slu4coder/Minimal-UART-CPU-FLASH-Edition/README.md

# Minimal UART CPU (Revision 1.3 aka FLASH Edition)

This repo is deprecated. The information you are looking for has moved to: https://github.com/slu4coder/Minimal-UART-CPU-System
