slu4coder/Minimal-UART-CPU-FLASH-Edition/(list of files, drawings)

Other design files:
KiCAD/8-Bit CPU 32k.dsn
