slu4coder/Minimal-UART-CPU-FLASH-Edition/KiCAD/8-Bit CPU 32k.kicad_pcb

## KiCad design KiCAD/8-Bit CPU 32k.kicad_pcb (2021-04-17, last stored version)

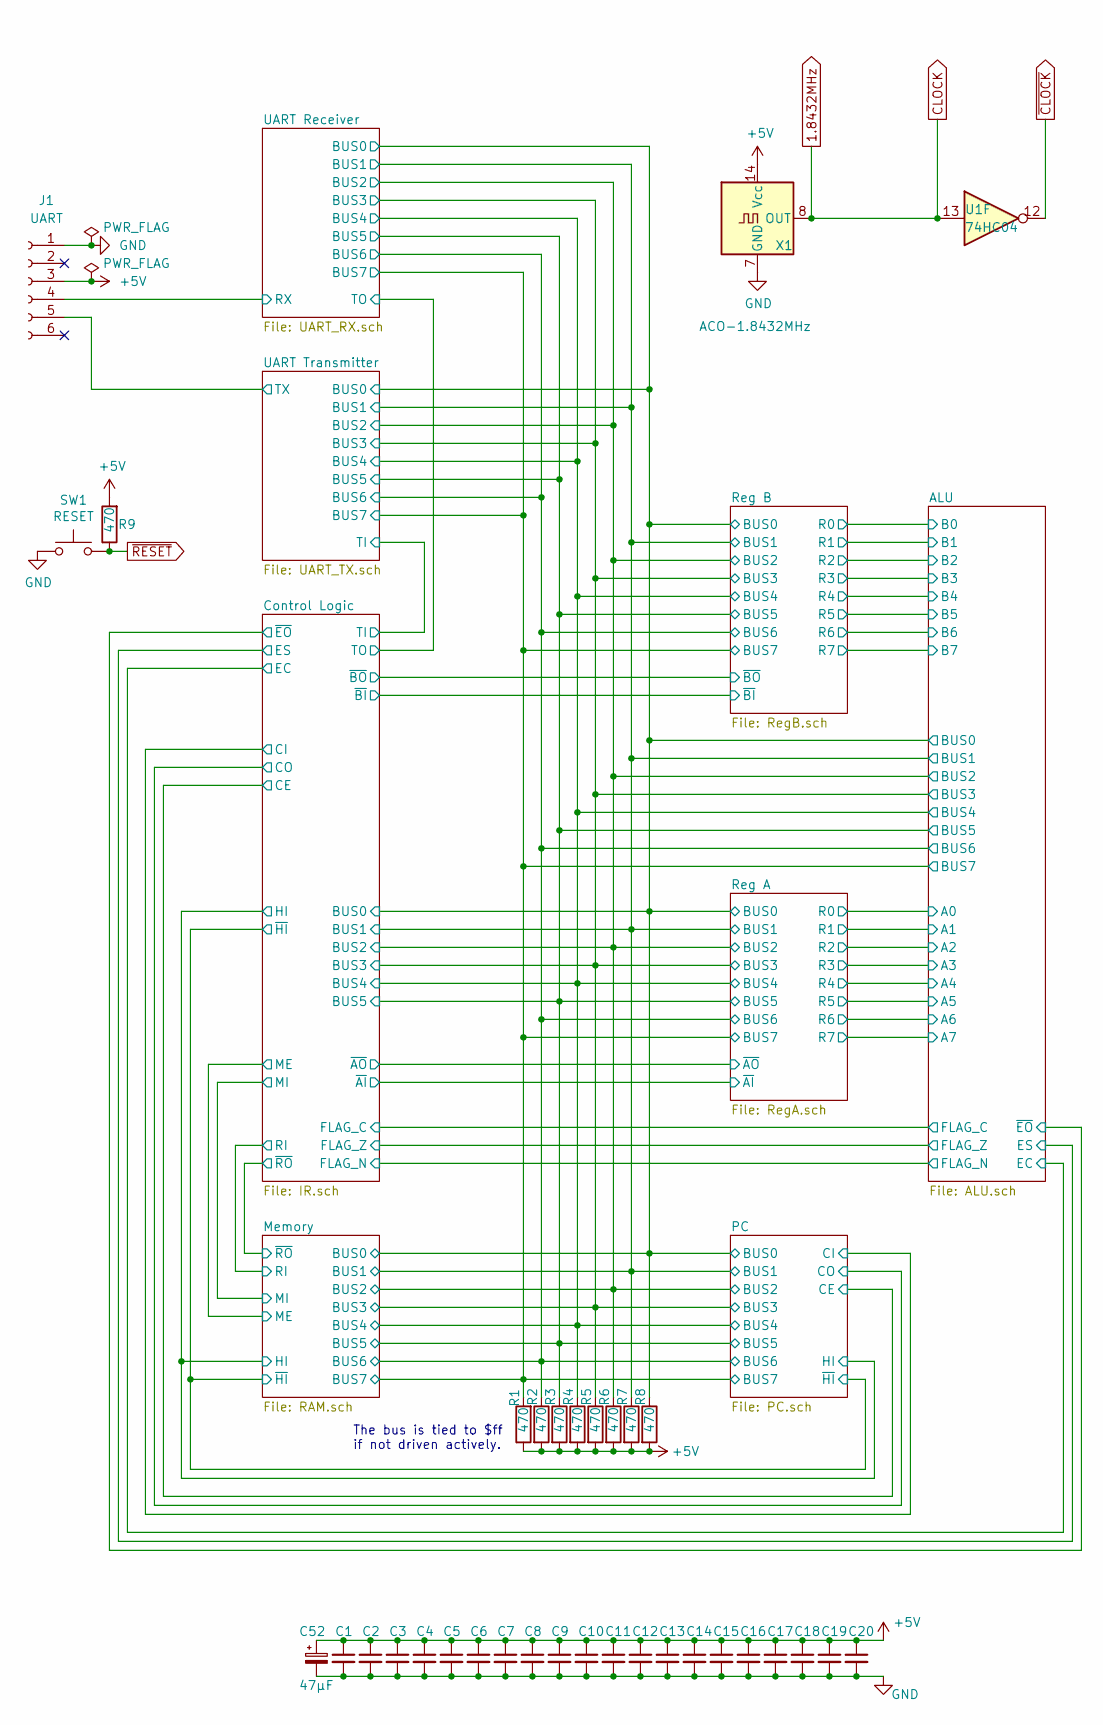
[picture p1: schematic 8-Bit CPU 32k.sch, Minimal UART Computer (FLASH Edition)]

Parts:
C1, C2, C3, C4, C5, C6, C7, C8, C9, C10, C11, C12, C13, C14, C15, C16, C17, C18, C19, C20: 100nF; C_Disc_D5.0mm_W2.5mm_P2.50mm
C52: 47µF; CP_Radial_D7.5mm_P2.50mm
J1: UART; PinSocket_1x06_P2.54mm_Vertical
R1, R2, R3, R4, R5, R6, R7, R8, R9: 470; R_Axial_DIN0207_L6.3mm_D2.5mm_P7.62mm_Horizontal
SW1: RESET; SW_PUSH_6mm
U1: 74HC04; DIP-14_W7.62mm
X1: ACO-1.8432MHz; Oscillator_DIP-14

Connections:
1.8432MHz: U1.13, X1.8 (OUT); also elsewhere on the board
+5V: C1.1, C2.1, C3.1, C4.1, C5.1, C6.1, C7.1, C8.1, C9.1, C10.1, C11.1, C12.1, C13.1, C14.1, C15.1, C16.1, C17.1, C18.1, C19.1, C20.1, C52.1, J1.3, R1.1, R2.2, R3.2, R4.2, R5.2, R6.2, R7.2, R8.2, R9.2, X1.14 (Vcc); also elsewhere on the board
/ALU/BUS0: R8.1; also elsewhere on the board
/ALU/BUS1: R7.1; also elsewhere on the board
/ALU/BUS2: R6.1; also elsewhere on the board
/ALU/BUS3: R5.1; also elsewhere on the board
/ALU/BUS4: R4.1; also elsewhere on the board
/ALU/BUS5: R3.1; also elsewhere on the board
/ALU/BUS6: R2.1; also elsewhere on the board
/ALU/BUS7: R1.2; also elsewhere on the board
/UART Receiver/RX: J1.4; also elsewhere on the board
/UART Transmitter/TX: J1.5; also elsewhere on the board
GND: C1.2, C2.2, C3.2, C4.2, C5.2, C6.2, C7.2, C8.2, C9.2, C10.2, C11.2, C12.2, C13.2, C14.2, C15.2, C16.2, C17.2, C18.2, C19.2, C20.2, C52.2, J1.1, SW1.1, X1.7 (GND); also elsewhere on the board
~CLOCK: U1.12; also elsewhere on the board
~RESET: R9.1, SW1.2; also elsewhere on the board

Notes on the sheet:
The bus is tied to $ff if not driven actively.

Schematic: RegA.sch, A Register

Parts:
U2, U3: 74HC173; DIP-16_W7.62mm
U4: 74HC245; DIP-20_W7.62mm

Connections:
1.8432MHz: U2.7, U3.7; also elsewhere on the board
+5V: U2.16, U3.16, U4.1 (A->B), U4.20 (VCC); also elsewhere on the board
/ALU/A0: U3.3, U4.2 (A0); also elsewhere on the board
/ALU/A1: U3.4, U4.3 (A1); also elsewhere on the board
/ALU/A2: U3.5, U4.4 (A2); also elsewhere on the board
/ALU/A3: U3.6, U4.5 (A3); also elsewhere on the board
/ALU/A4: U2.3, U4.6 (A4); also elsewhere on the board
/ALU/A5: U2.4, U4.7 (A5); also elsewhere on the board
/ALU/A6: U2.5, U4.8 (A6); also elsewhere on the board
/ALU/A7: U2.6, U4.9 (A7); also elsewhere on the board
/ALU/BUS0: U3.14, U4.18 (B0); also elsewhere on the board
/ALU/BUS1: U3.13, U4.17 (B1); also elsewhere on the board
/ALU/BUS2: U3.12, U4.16 (B2); also elsewhere on the board
/ALU/BUS3: U3.11, U4.15 (B3); also elsewhere on the board
/ALU/BUS4: U2.14, U4.14 (B4); also elsewhere on the board
/ALU/BUS5: U2.13, U4.13 (B5); also elsewhere on the board
/ALU/BUS6: U2.12, U4.12 (B6); also elsewhere on the board
/ALU/BUS7: U2.11, U4.11 (B7); also elsewhere on the board
/Control Logic/~AI: U2.9, U2.10, U3.9, U3.10; also elsewhere on the board
/Control Logic/~AO: U4.19 (CE); also elsewhere on the board
GND: U2.1, U2.2, U2.8, U2.15, U3.1, U3.2, U3.8, U3.15, U4.10 (GND); also elsewhere on the board

Schematic: ALU.sch, Arithmetic and Logic Unit

Parts:
U12, U16: 74HC86; DIP-14_W7.62mm
U13, U14: 74HC283; DIP-16_W7.62mm
U15: 74HC245; DIP-20_W7.62mm
U18: 74HC02; DIP-14_W7.62mm
U19: 74HC08; DIP-14_W7.62mm

Connections:
+5V: U12.14 (VCC), U13.16, U14.16, U15.20 (VCC), U16.14 (VCC), U18.14 (VCC), U19.14 (VCC); also elsewhere on the board
/ALU/A0: U14.5; also elsewhere on the board
/ALU/A1: U14.3; also elsewhere on the board
/ALU/A2: U14.14; also elsewhere on the board
/ALU/A3: U14.12; also elsewhere on the board
/ALU/A4: U13.5; also elsewhere on the board
/ALU/A5: U13.3; also elsewhere on the board
/ALU/A6: U13.14; also elsewhere on the board
/ALU/A7: U13.12; also elsewhere on the board
/ALU/B0: U16.13; also elsewhere on the board
/ALU/B1: U16.10; also elsewhere on the board
/ALU/B2: U16.5; also elsewhere on the board
/ALU/B3: U16.2; also elsewhere on the board
/ALU/B4: U12.13; also elsewhere on the board
/ALU/B5: U12.10; also elsewhere on the board
/ALU/B6: U12.5; also elsewhere on the board
/ALU/B7: U12.2; also elsewhere on the board
/ALU/BUS0: U15.2 (A0); also elsewhere on the board
/ALU/BUS1: U15.3 (A1); also elsewhere on the board
/ALU/BUS2: U15.4 (A2); also elsewhere on the board
/ALU/BUS3: U15.5 (A3); also elsewhere on the board
/ALU/BUS4: U15.6 (A4); also elsewhere on the board
/ALU/BUS5: U15.7 (A5); also elsewhere on the board
/ALU/BUS6: U15.8 (A6); also elsewhere on the board
/ALU/BUS7: U15.9 (A7); also elsewhere on the board
/ALU/EC: U14.7; also elsewhere on the board
/ALU/ES: U12.1, U12.4, U12.9, U12.12, U16.1, U16.4, U16.9, U16.12; also elsewhere on the board
/ALU/FLAG_C: U13.9; also elsewhere on the board
/ALU/FLAG_N: U13.10, U15.11 (B7), U18.12; also elsewhere on the board
/ALU/FLAG_Z: U19.6; also elsewhere on the board
/ALU/~EO: U15.19 (CE); also elsewhere on the board
GND: U12.7 (GND), U13.8, U14.8, U15.1 (A->B), U15.10 (GND), U16.7 (GND), U18.7 (GND), U19.7 (GND); also elsewhere on the board
unnamed: U12.3, U13.11
unnamed: U12.6, U13.15
unnamed: U12.8, U13.2
unnamed: U12.11, U13.6
unnamed: U13.1, U15.13 (B5), U18.9
unnamed: U13.4, U15.14 (B4), U18.8
unnamed: U13.7, U14.9
unnamed: U13.13, U15.12 (B6), U18.11
unnamed: U14.1, U15.17 (B1), U18.3
unnamed: U14.2, U16.8
unnamed: U14.4, U15.18 (B0), U18.2
unnamed: U14.6, U16.11
unnamed: U14.10, U15.15 (B3), U18.6
unnamed: U14.11, U16.3
unnamed: U14.13, U15.16 (B2), U18.5
unnamed: U14.15, U16.6
unnamed: U18.1, U19.1
unnamed: U18.4, U19.2
unnamed: U18.10, U19.12
unnamed: U18.13, U19.13
unnamed: U19.3, U19.4
unnamed: U19.5, U19.11

Notes on the sheet:
Left-over AND used in UART receier.

Schematic: UART_RX.sch, UART Receiver

Parts:
U1: 74HC04; DIP-14_W7.62mm
U19: 74HC08; DIP-14_W7.62mm
U20: 74HC173; DIP-16_W7.62mm
U34: 74HC161; DIP-16_W7.62mm
U35: 74HC00; DIP-14_W7.62mm
U37: 74HC193; DIP-16_W7.62mm
U39: 74HC164; DIP-14_W7.62mm
U41: 74HC245; DIP-20_W7.62mm

Connections:
1.8432MHz: U34.2, U35.13; also elsewhere on the board
+5V: U20.16, U34.7, U34.9, U34.10, U34.16, U35.14 (VCC), U37.5, U37.9, U37.15, U37.16, U39.2 (DSB), U39.9 (~MR), U39.14 (VCC), U41.1 (A->B), U41.20 (VCC); also elsewhere on the board
/ALU/BUS0: U41.11 (B7); also elsewhere on the board
/ALU/BUS1: U41.12 (B6); also elsewhere on the board
/ALU/BUS2: U41.13 (B5); also elsewhere on the board
/ALU/BUS3: U41.14 (B4); also elsewhere on the board
/ALU/BUS4: U41.15 (B3); also elsewhere on the board
/ALU/BUS5: U41.16 (B2); also elsewhere on the board
/ALU/BUS6: U41.17 (B1); also elsewhere on the board
/ALU/BUS7: U41.18 (B0); also elsewhere on the board
/ALU/FLAG_Z: U19.6; also elsewhere on the board
/Control Logic/TO: U35.10; also elsewhere on the board
/UART Receiver/RX: U35.1, U39.1 (DSA); also elsewhere on the board
GND: U20.1, U20.2, U20.8, U20.9, U20.10, U20.11, U20.12, U20.13, U20.15, U34.8, U35.7 (GND), U37.1, U37.8, U37.10, U37.14, U39.7 (GND), U41.10 (GND); also elsewhere on the board
unnamed: U1.5, U19.10, U37.13
unnamed: U1.6, U20.14
unnamed: U1.10, U35.12
unnamed: U1.11, U35.8, U41.19 (CE)
unnamed 103: U19.1; also elsewhere on the board
unnamed 104: U19.2; also elsewhere on the board
unnamed 105: U19.12; also elsewhere on the board
unnamed 106: U19.13; also elsewhere on the board
unnamed: U19.3, U19.4
unnamed: U19.8, U34.1
unnamed: U19.9, U35.3, U35.4, U37.11
unnamed: U19.5, U19.11
unnamed: U20.3, U35.9
unnamed: U34.11, U37.4, U39.8 (CP)
unnamed: U35.2, U35.6
unnamed: U35.5, U35.11
unnamed: U39.3 (Q0), U41.2 (A0)
unnamed: U39.4 (Q1), U41.3 (A1)
unnamed: U39.5 (Q2), U41.4 (A2)
unnamed: U39.6 (Q3), U41.5 (A3)
unnamed: U39.10 (Q4), U41.6 (A4)
unnamed: U39.11 (Q5), U41.7 (A5)
unnamed: U39.12 (Q6), U41.8 (A6)
unnamed: U39.13 (Q7), U41.9 (A7)
~CLOCK: U20.7; also elsewhere on the board

Notes on the sheet:
~RESET
~SET
AND from ALU
SYNC_DATA_READY

Schematic: UART_TX.sch, UART Transmitter

Parts:
U42: 74HC161; DIP-16_W7.62mm
U43, U45: 74HC165; DIP-16_W7.62mm
U44: 74HC00; DIP-14_W7.62mm

Connections:
1.8432MHz: U42.2, U44.13; also elsewhere on the board
+5V: U42.7, U42.9, U42.10, U42.16, U43.6, U43.16, U45.3, U45.4, U45.10, U45.11, U45.12, U45.13, U45.14, U45.16; also elsewhere on the board
/ALU/BUS0: U43.4; also elsewhere on the board
/ALU/BUS1: U43.3; also elsewhere on the board
/ALU/BUS2: U43.14; also elsewhere on the board
/ALU/BUS3: U43.13; also elsewhere on the board
/ALU/BUS4: U43.12; also elsewhere on the board
/ALU/BUS5: U43.11; also elsewhere on the board
/ALU/BUS6: U45.6; also elsewhere on the board
/ALU/BUS7: U45.5; also elsewhere on the board
/Control Logic/TI: U44.12; also elsewhere on the board
/UART Transmitter/TX: U43.9; also elsewhere on the board
GND: U42.8, U43.5, U43.8, U43.15, U45.8, U45.15; also elsewhere on the board
unnamed: U42.1, U43.1, U44.11, U45.1
unnamed: U42.11, U43.2, U45.2
unnamed: U43.10, U45.9

Notes on the sheet:
Left-over NAND from MAR
Transfers bus data only during second clockphase.

Schematic: PC.sch, Program Counter

Parts:
U46, U49, U51, U52: 74HC161; DIP-16_W7.62mm
U48: 74HC00; DIP-14_W7.62mm
U50, U53: 74HC245; DIP-20_W7.62mm

Connections:
1.8432MHz: U46.2, U49.2, U51.2, U52.2; also elsewhere on the board
+5V: U46.16, U48.14 (VCC), U49.16, U50.20 (VCC), U51.16, U52.16, U53.20 (VCC); also elsewhere on the board
/ALU/BUS0: U49.3, U50.2 (A0), U52.3, U53.2 (A0); also elsewhere on the board
/ALU/BUS1: U49.4, U50.3 (A1), U52.4, U53.3 (A1); also elsewhere on the board
/ALU/BUS2: U49.5, U50.4 (A2), U52.5, U53.4 (A2); also elsewhere on the board
/ALU/BUS3: U49.6, U50.5 (A3), U52.6, U53.5 (A3); also elsewhere on the board
/ALU/BUS4: U46.3, U50.6 (A4), U51.3, U53.6 (A4); also elsewhere on the board
/ALU/BUS5: U46.4, U50.7 (A5), U51.4, U53.7 (A5); also elsewhere on the board
/ALU/BUS6: U46.5, U50.8 (A6), U51.5, U53.8 (A6); also elsewhere on the board
/ALU/BUS7: U46.6, U50.9 (A7), U51.6, U53.9 (A7); also elsewhere on the board
/Control Logic/CE: U46.7, U49.7, U51.7, U52.7, U52.10; also elsewhere on the board
/Control Logic/CI: U48.10, U48.12; also elsewhere on the board
/Control Logic/CO: U48.2, U48.4; also elsewhere on the board
/Control Logic/HI: U48.1, U48.13; also elsewhere on the board
/Control Logic/~HI: U48.5, U48.9; also elsewhere on the board
GND: U46.8, U48.7 (GND), U49.8, U50.1 (A->B), U50.10 (GND), U51.8, U52.8, U53.1 (A->B), U53.10 (GND); also elsewhere on the board
unnamed: U46.9, U48.11, U49.9
unnamed: U46.10, U49.15
unnamed: U46.11, U50.11 (B7)
unnamed: U46.12, U50.12 (B6)
unnamed: U46.13, U50.13 (B5)
unnamed: U46.14, U50.14 (B4)
unnamed: U48.3, U50.19 (CE)
unnamed: U48.6, U53.19 (CE)
unnamed: U48.8, U51.9, U52.9
unnamed: U49.10, U51.15
unnamed: U49.11, U50.15 (B3)
unnamed: U49.12, U50.16 (B2)
unnamed: U49.13, U50.17 (B1)
unnamed: U49.14, U50.18 (B0)
unnamed: U51.10, U52.15
unnamed: U51.11, U53.11 (B7)
unnamed: U51.12, U53.12 (B6)
unnamed: U51.13, U53.13 (B5)
unnamed: U51.14, U53.14 (B4)
unnamed: U52.11, U53.15 (B3)
unnamed: U52.12, U53.16 (B2)
unnamed: U52.13, U53.17 (B1)
unnamed: U52.14, U53.18 (B0)
~RESET: U46.1, U49.1, U51.1, U52.1; also elsewhere on the board

Notes on the sheet:
~COH
~COL
~CIL
~CIH

Schematic: RegB.sch, B Register

Parts:
U10, U17: 74HC173; DIP-16_W7.62mm
U23: 74HC245; DIP-20_W7.62mm

Connections:
1.8432MHz: U10.7, U17.7; also elsewhere on the board
+5V: U10.16, U17.16, U23.1 (A->B), U23.20 (VCC); also elsewhere on the board
/ALU/B0: U17.3, U23.2 (A0); also elsewhere on the board
/ALU/B1: U17.4, U23.3 (A1); also elsewhere on the board
/ALU/B2: U17.5, U23.4 (A2); also elsewhere on the board
/ALU/B3: U17.6, U23.5 (A3); also elsewhere on the board
/ALU/B4: U10.3, U23.6 (A4); also elsewhere on the board
/ALU/B5: U10.4, U23.7 (A5); also elsewhere on the board
/ALU/B6: U10.5, U23.8 (A6); also elsewhere on the board
/ALU/B7: U10.6, U23.9 (A7); also elsewhere on the board
/ALU/BUS0: U17.14, U23.18 (B0); also elsewhere on the board
/ALU/BUS1: U17.13, U23.17 (B1); also elsewhere on the board
/ALU/BUS2: U17.12, U23.16 (B2); also elsewhere on the board
/ALU/BUS3: U17.11, U23.15 (B3); also elsewhere on the board
/ALU/BUS4: U10.14, U23.14 (B4); also elsewhere on the board
/ALU/BUS5: U10.13, U23.13 (B5); also elsewhere on the board
/ALU/BUS6: U10.12, U23.12 (B6); also elsewhere on the board
/ALU/BUS7: U10.11, U23.11 (B7); also elsewhere on the board
/Control Logic/~BI: U10.9, U10.10, U17.9, U17.10; also elsewhere on the board
/Control Logic/~BO: U23.19 (CE); also elsewhere on the board
GND: U10.1, U10.2, U10.8, U10.15, U17.1, U17.2, U17.8, U17.15, U23.10 (GND); also elsewhere on the board

Schematic: RAM.sch, RAM, ROM and MAR

Parts:
U1: 74HC04; DIP-14_W7.62mm
U26, U28, U30, U33: 74HC161; DIP-16_W7.62mm
U31: SST39SF010A ROM; DIP-32_W15.24mm_Socket
U32: CY62256 32k RAM; DIP-28_W15.24mm
U44: 74HC00; DIP-14_W7.62mm

Connections:
1.8432MHz: U26.2, U28.2, U30.2, U33.2, U44.10; also elsewhere on the board
+5V: U26.1, U26.16, U28.1, U28.16, U30.1, U30.16, U31.32, U32.28, U33.1, U33.16, U44.14 (VCC); also elsewhere on the board
/ALU/BUS0: U28.3, U31.13, U32.11, U33.3; also elsewhere on the board
/ALU/BUS1: U28.4, U31.14, U32.12, U33.4; also elsewhere on the board
/ALU/BUS2: U28.5, U31.15, U32.13, U33.5; also elsewhere on the board
/ALU/BUS3: U28.6, U31.17, U32.15, U33.6; also elsewhere on the board
/ALU/BUS4: U26.3, U30.3, U31.18, U32.16; also elsewhere on the board
/ALU/BUS5: U26.4, U30.4, U31.19, U32.17; also elsewhere on the board
/ALU/BUS6: U26.5, U30.5, U31.20, U32.18; also elsewhere on the board
/ALU/BUS7: U26.6, U30.6, U31.21, U32.19; also elsewhere on the board
/Control Logic/CE: U26.7, U28.7, U30.7, U33.7, U33.10; also elsewhere on the board
/Control Logic/HI: U44.5; also elsewhere on the board
/Control Logic/MI: U44.2, U44.4; also elsewhere on the board
/Control Logic/RI: U44.9; also elsewhere on the board
/Control Logic/~HI: U44.1; also elsewhere on the board
/Control Logic/~RO: U31.24, U32.22; also elsewhere on the board
/Memory/M0: U31.12, U32.21, U33.14
/Memory/M1: U31.11, U32.23, U33.13
/Memory/M2: U31.10, U32.24, U33.12
/Memory/M3: U31.9, U32.25, U33.11
/Memory/M4: U30.14, U31.8, U32.26
/Memory/M5: U30.13, U31.7, U32.1
/Memory/M6: U30.12, U31.6, U32.2
/Memory/M7: U30.11, U31.5, U32.3
/Memory/M8: U28.14, U31.27, U32.4
/Memory/M9: U28.13, U31.26, U32.5
/Memory/M10: U28.12, U31.23, U32.6
/Memory/M11: U28.11, U31.25, U32.7
/Memory/M12: U26.14, U31.4, U32.8
/Memory/M13: U26.13, U31.28, U32.9
/Memory/M14: U26.12, U31.29, U32.10
/Memory/M15: U1.9, U26.11, U31.22
GND: U26.8, U28.8, U30.8, U31.2, U31.3, U31.16, U32.14, U33.8, U44.7 (GND); also elsewhere on the board
unnamed: U1.8, U32.20
unnamed: U26.9, U28.9, U44.6
unnamed: U26.10, U28.15
unnamed: U28.10, U30.15
unnamed: U30.9, U33.9, U44.3
unnamed: U30.10, U33.15
unnamed: U31.31, U32.27, U44.8

Notes on the sheet:
~MIL
~MIH
~ROM_CE
~RAM_CE
NAND used in TX
A separate reset of the MAR is not needed. During the time RESET is pressed, the clock runs with SC=0 and PC=0. This ensures that with CO|MI MAL=0.
Writing only during second clockphase. ~RI~ alone would be valid even after the clock phase ended -> not good!

Schematic: IR.sch, Control Logic

Parts:
C21, C24: 200pF; C_Disc_D5.0mm_W2.5mm_P2.50mm
C22, C23: 0pF; C_Disc_D5.0mm_W2.5mm_P2.50mm
U1: 74HC04; DIP-14_W7.62mm
U5, U6, U8: 74HC173; DIP-16_W7.62mm
U7: SST39SF010A MSB; DIP-32_W15.24mm_Socket
U9: SST39SF010A LSB; DIP-32_W15.24mm_Socket
U11: 74HC161; DIP-16_W7.62mm
U40: 74HC08; DIP-14_W7.62mm

Connections:
1.8432MHz: U5.7, U6.7, U8.7; also elsewhere on the board
+5V: U1.14 (VCC), U5.16, U6.16, U7.31, U7.32, U8.16, U9.31, U9.32, U11.7, U11.9, U11.10, U11.16, U40.14; also elsewhere on the board
/ALU/BUS0: U8.14; also elsewhere on the board
/ALU/BUS1: U8.13; also elsewhere on the board
/ALU/BUS2: U8.12; also elsewhere on the board
/ALU/BUS3: U8.11; also elsewhere on the board
/ALU/BUS4: U6.14; also elsewhere on the board
/ALU/BUS5: U6.13; also elsewhere on the board
/ALU/EC: U7.15; also elsewhere on the board
/ALU/ES: U7.14; also elsewhere on the board
/ALU/FLAG_C: U5.13; also elsewhere on the board
/ALU/FLAG_N: U5.12; also elsewhere on the board
/ALU/FLAG_Z: U5.14; also elsewhere on the board
/ALU/~EO: U5.9, U5.10, U7.13; also elsewhere on the board
/Control Logic/CE: U1.3, U7.19; also elsewhere on the board
/Control Logic/CI: U7.21; also elsewhere on the board
/Control Logic/CO: U7.20; also elsewhere on the board
/Control Logic/HI: C23.2, U1.1, U9.21, U40.9; also elsewhere on the board
/Control Logic/MI: U9.20; also elsewhere on the board
/Control Logic/RI: C24.2, U9.19; also elsewhere on the board
/Control Logic/TI: U40.8; also elsewhere on the board
/Control Logic/TO: U40.3; also elsewhere on the board
/Control Logic/~AI: U9.17; also elsewhere on the board
/Control Logic/~AO: U9.15; also elsewhere on the board
/Control Logic/~BI: U9.14; also elsewhere on the board
/Control Logic/~BO: U9.13; also elsewhere on the board
/Control Logic/~HI: U1.2, U6.9, U8.9, U40.2; also elsewhere on the board
/Control Logic/~RO: U9.18; also elsewhere on the board
GND: C21.1, C22.1, C23.1, C24.1, U1.7 (GND), U5.1, U5.2, U5.8, U5.11, U5.15, U6.1, U6.2, U6.8, U6.11, U6.12, U6.15, U7.2, U7.3, U7.16, U7.22, U7.24, U7.28, U7.29, U8.1, U8.2, U8.8, U8.15, U9.2, U9.3, U9.16, U9.22, U9.24, U9.28, U9.29, U11.8, U40.7, U40.12, U40.13; also elsewhere on the board
unnamed: C21.2, U7.18, U40.1, U40.10
unnamed: C22.2, U7.17, U40.5
unnamed: U1.4, U6.10, U8.10
unnamed: U5.3, U7.23, U9.23
unnamed: U5.4, U7.25, U9.25
unnamed: U5.5, U7.4, U9.4
unnamed: U6.3, U7.27, U9.27
unnamed: U6.4, U7.26, U9.26
unnamed: U7.5, U8.6, U9.5
unnamed: U7.6, U8.5, U9.6
unnamed: U7.7, U8.4, U9.7
unnamed: U7.8, U8.3, U9.8
unnamed: U11.1, U40.6
unnamed: U7.9, U9.9, U11.11
unnamed: U7.10, U9.10, U11.12
unnamed: U7.11, U9.11, U11.13
unnamed: U7.12, U9.12, U11.14
~CLOCK: U11.2; also elsewhere on the board
~RESET: U40.4; also elsewhere on the board

Notes on the sheet:
~FI~ together with ~EO~
~IC
The caps suppress false triggering of level- triggered control signals due to switching spikes.
Instruction Step Counter
Instruction Register
Flags Register

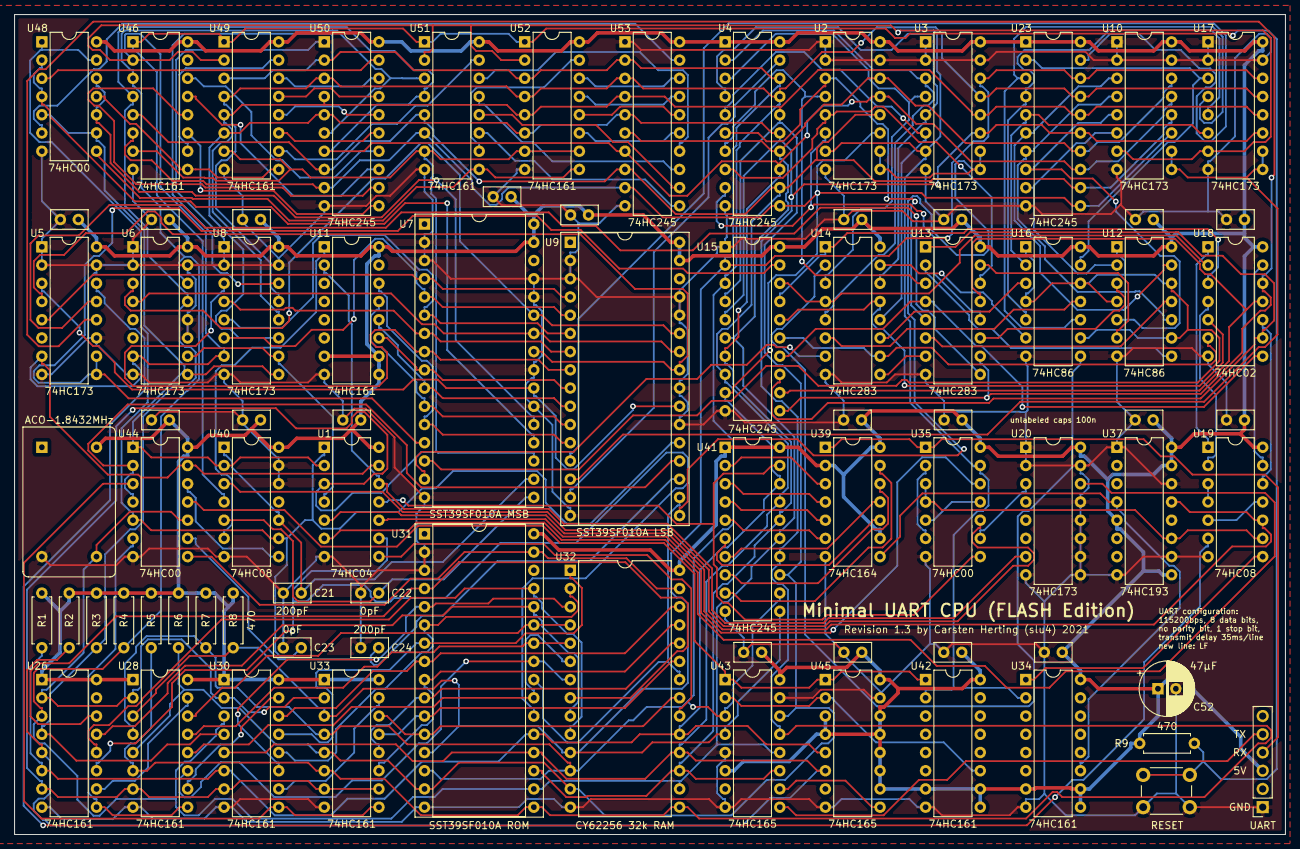
[picture p2: board 8-Bit CPU 32k.kicad_pcb from above]

Board: 2 copper layers, 177.2 x 114.3 mm, 81 parts (0 on the bottom side), 157 nets.
