slu4coder/Minimal-UART-CPU-FLASH-Edition/(commit log)

2021-02-13 Revision 1.3.1
    [8-Bit CPU 32k.dsn, 8-Bit CPU 32k.kicad_pcb, 8-Bit CPU 32k.sch, ALU.sch, IR.sch, PC.sch, RAM.sch, RegA.sch]
2021-03-10 Revision 1.3.2
    Updated explanatory text. No changes to the schematic or layout.
2021-03-19 Revision 1.4
    [Instruction Set.ods]
2021-04-17 Revision 1.3.2
    [8-Bit CPU 32k.kicad_pcb, 8-Bit CPU 32k.sch, IR.sch, UART_RX.sch, UART_TX.sch]
2021-04-17 Revision 1.5
    Use for board revisions 1.3 and higher.
2021-04-28 Updated assembler format
