slu4coder/Minimal-UART-CPU-FLASH-Edition/(notices)

Notices in the files:
KiCAD/UART_TX.sch:
creativecommons.org/licenses/by-nc-sa/3.0/deed.en
License: CC BY-NC-SA 3.0
